OKMCU/wifi-lock/documents/密码键盘+磁力锁硬件BOM.xlsx

Sheet: Mechanical
编号 | 名称 | 型号 | 用量 | 单位 | 单价 | 最小订单量 | 最小订单价格 | 运费 | 淘宝链接 | 备注
1 | 安防门禁密码锁塑胶外壳 | FSDF-6-127 | 1 | 套 | 12 | 1 | 12 | 8 | https://item.taobao.com/item.htm?id=23332572481 | 问店家是否有机械图尺寸？
2 | 280kg单门磁力锁（信号反馈+延时） | KT-L280 | 1 | 套 | 80 | 1 | 80 | 0 | https://detail.tmall.com/item.htm?id=9399868506 | 注意安装是否需要其他配件？
3 | 螺丝等 |  |  |  | 0 | 100 | 0 | 10 |  | 小钱，螺丝暂不知用哪种，未知价格

Sheet: Electronic
编号 | 名称 | 型号 | 封装 | 用量 | 单价 | 小计 | 最小订单量 | 最小订单价格 | 运费 | 淘宝链接 | 备注
1 | PCB板 | NA | NA | 1 | 15 | 15 | 10 | 150 | 0 | https://www.sz-jlc.com | 配合键盘导电橡胶要沉金工艺防触点氧化
2 | 12V 2A 电源适配器 | NA | NA | 1 | 10.5 | 10.5 | 1 | 10.5 | 8 | https://item.taobao.com/item.htm?id=524330149101 | 最好买有地线的电源
3 | MCU处理器 | M0516LDN | LQFP-48 | 1 | 6.8 | 6.8 | 5 | 34 | 6 | https://detail.tmall.com/item.htm?id=525069682374
4 | DC-DC稳压IC | TPS5430 | SOP-8 | 1 | 3.6 | 3.6 | 5 | 18 | 3 | https://item.taobao.com/item.htm?id=547035722114
5 | 30V 5.8A N-Channel MOSFET, MAX VGS = 1.45V | AO3400 | SOT-23 | 1 | 0.24 | 0.24 | 5 | 1.2 | 3 | https://item.taobao.com/item.htm?id=580014680257
6 | Buzzers Transducer, Externally Driven Magnetic 1.5V 10mA 2.048kHz 82dB @ 1.5V, 10cm Through Hole PC Pins | AT-1220-TT-R | 1201 | 1 | 0.36 | 0.36 | 5 | 1.8 | 3 | https://item.taobao.com/item.htm?id=556001425832
7 | CAP0603 | 100nF | 0603 | 6 | 0.1 | 0.6 | 100 | 10 | 3 | NA
8 | CAP0603 | 100pF | 0603 | 1 | 0.1 | 0.1 | 100 | 10 | 3 | NA
9 | CAP0603 | 10uF | 0603 | 6 | 0.1 | 0.6 | 100 | 10 | 3 | NA
10 | 220μF 16V Aluminum Electrolytic Capacitors Radial, Can - SMD 160 mohm @ 100kHz 2000 Hrs @ 105°C | 220uF | SMD-EC-F6.3 | 1 | 0.13 | 0.13 | 50 | 6.5 | 3 | https://item.taobao.com/item.htm?id=550716514634
11 | ESP-12S Wi-Fi Module | ESP-12S | ESP-12S | 1 | 11.3 | 11.3 | 1 | 11.3 | 6 | https://item.taobao.com/item.htm?id=542762874623
12 | Header, 2-Pin, Dual row | Header 2*5 | 2.54mm Pitch | 1 | 0.2 | 0.2 | 10 | 2 | 3 | NA
13 | Typical INFRARED GaAs LED | LED | 0603 | 1 | 0.1 | 0.1 | 100 | 10 | 3 | NA
14 | Red & Blue | LED | DLED2.00x1.25mm | 1 | 0.1 | 0.1 | 100 | 10 | 3 | NA
15 | High Voltage Transistor, PNP Silicon, 3-Pin SOT-23, Pb-Free, Tape and Reel | MMBT5401LT1G | SOT-23 | 2 | 0.12 | 0.24 | 10 | 1.2 | 3 | https://item.taobao.com/item.htm?id=586188477523
16 | 0603 Resistor, 1/16W, 5% | 0R | 0603 | 1 | 0.01 | 0.01 | 100 | 1 | 0
17 | 0603 Resistor, 1/16W, 5% | 100R | 0603 | 3 | 0.01 | 0.03 | 100 | 1 | 0
18 | 0603 Resistor, 1/16W, 5% | 10k | 0603 | 4 | 0.01 | 0.04 | 100 | 1 | 0
19 | 0603 Resistor, 1/16W, 5% | 33k | 0603 | 2 | 0.01 | 0.02 | 100 | 1 | 0
20 | 0603 Resistor, 1/16W, 5% | 4.7k | 0603 | 4 | 0.01 | 0.04 | 100 | 1 | 0
21 | 0603 Resistor, 1/16W, 5% | 51R | 0603 | 1 | 0.01 | 0.01 | 100 | 1 | 0
