OKMCU/wifi-lock/documents/BOM.xls

Comment | Description | Designator | Footprint | LibRef | Quantity
AMS1117 | 三端线性稳压 | U1 | SOT-223 | AMS1117 | 1
AO3400 | 30V 5.8A N-Channel MOSFET, MAX VGS = 1.45V | Q2 | SOT95P230X110-3N | AO3400 | 1
AT-1220-TT-R | Buzzers Transducer, Externally Driven Magnetic 1.5V 10mA 2.048kHz 82dB @ 1.5V, 10cm Through Hole PC Pins | U3 | Transducer_12mm(D)x8.5mm(H)_6.5mm(P) | AT-1220-TT-R | 1
100nF | CAP0603 | C2, C4, C5, C6, C9, C11 | 0603 | CAP0603 | 6
100pF | CAP0603 | C14 | 0603 | CAP0603 | 1
10uF | CAP0603 | C1, C3, C8, C10, C12, C13 | 0603 | CAP0603 | 6
SS32 | SS32 | D2 | DO-214AC | Diode | 1
220uF | 220μF 16V Aluminum Electrolytic Capacitors Radial, Can - SMD 160 mohm @ 100kHz 2000 Hrs @ 105°C | C7 | SMD-EC-F6.3 | EEE-FPC221XAP | 1
ESP07S | ESP-07S Wi-Fi Module | M1 | ESP-07S Module | ESP-07S Module | 1
Header 2*5 | Header, 2-Pin, Dual row | P1 | HDR2X5T0.1 | Header 2*5 | 1
LED | Typical INFRARED GaAs LED | D3 | 0603 | LED | 1
LED | Red & Blue | D4 | DLED2.00x1.25mm | LED-RB | 1
M0516LDN | ARM Cortex -M0 32-bit Microcontroller | U2 | LQFP-48 | M0516LDN | 1
MMBT5401LT1G | High Voltage Transistor, PNP Silicon, 3-Pin SOT-23, Pb-Free, Tape and Reel | Q1, Q3 | ONSC-SOT-23-3-318-08_V | MMBT5401LT1G | 2
0R |  | R10 | 0603 | RES | 1
100R |  | R11, R12, R13 | 0603 | RES | 3
10k |  | R1, R2, R4, R6 | 0603 | RES | 4
33k |  | R8, R9 | 0603 | RES | 2
4.7k |  | R3, R5, R7, R15 | 0603 | RES | 4
51R |  | R14 | 0603 | RES | 1
KEY0 | Top push Switch | S0 | SW6.00x3.00mm | SW-TACT | 1
Terminal Screw 4-PIN PCB RA | Terminal Screw 4-PIN, Thru Hole, PCB Right Angle | J1, J2 | TERMSCREW4-B11.5X8.5X7.8mm/T5.0X7.5mm/RA | Terminal Screw 4-PIN PCB RA | 2
