OKMCU/wifi-lock/documents/CMD.xls

ID | Server |  | Client | Remarks
1 | @heart | <-----> | @heart | Heart Beat Packet. 1. Client will send "@heart" every 30 seconds to keep the connection alive. 2. Once received "@heart" from client, the server should echo "@heart" to client. 3. If the client does not receive "@heart" in 60 seconds, it will sending request to server to close the websocket connection.
2 | UUID? | <-----> | UUID:XX-XX-XX-XX-XX-XX-XX-XX-XX-XX-XX-XX-XX-XX-XX-XX | Universal Unique ID. 1. Every client has its own UUID. 2. Server can distinguish client by using UUID and mapping it to corresponding location or ShareOffice ID.
3 | VERIFY!{VCODE} e.g. VERIFY!AA-BB-AA-BB-AA-BB-AA-BB-AA-BB-AA-BB-AA-BB-AA-BB | <-----> | VERIFY:{ANSWER} e.g. VERIFY:CC-DD-CC-DD-CC-CC-DD-CC-DD-CC-CC-DD-CC-DD-CC-DD | Client verification. 1. Since the UUID can be sniffed by a hacker. There is a risk that the hacker can connect to server and report the same UUID in order to pose as a client. Thus, it's necessary for the server to verify the client. Steps are as below. Step 1. Server sends a verification code(VCODE) to client. VCODE should be always different. Recommanded to use VCODE = MD5(ServerTime). Step 2. Once the client receives the VCODE, it will calculate the ANSWER and reply to the server. ANSWER = MD5(VCODE+VID) ---- "+" means "VCODE.toBytes[i] + VID.toBytes[i]", where i=0~46. VCODE = MD5(ServerTime )---- Verification Code = MD5 of Server Time. VID = MD5(DEVID) ---- Verification ID = MD5 of the Device ID. Step 3. Once the server receives the answer from the client, it should check the answer is correct or not. If not correct, or the server does not receives the reply in a limited time, the server should close the connection and block the IP address for a while, such as 60sec. 2. If the server sends an illegal VCODE, e.g, "01-02-03-04", "01-02-03-04-05-06-07-08-09-10-11-12-13-14-15" "01-02-03-04-05-06-07-08-09-10-11-12-13-14-15-16-17" "01-02-03-04-05-06-07-08-09-10-11-12-13-14-15-16-1G" "01-02-03-04-05-06-07-08-09-10-11-12-13-14-15-16--17" "01-02-03-04-05-06-07-08-09-10-11-12-13-14-15-1617" then, the client will reply "VERIFY:00-00-00-00-00-00-00-00-00-00-00-00-00-00-00-00". 3. At debug stage, server can any string starting with "VERIFY!", such as "VERIFY!TEST", which is an illeg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
4 | STATE? | <-----> | STATE:OPENED STATE:CLOSED | Check the door status. 1. Reply "STATE:OPENED" if door is opened. 2. Reply "STATE:CLOSED" if door is closed.
5 | OPEN! | <-----> | OPEN:OK | Request to open the lock. 1. Client will always reply "OK" when receives the request. 2. Client will open the lock. Notice that "Lock Open" does not means "Door Open". 3. Thers's a hard time limitation of 5 seconds for "OPEN!" command. That means if server sends "OPEN!" twice or more times within 5 seconds, only the first "OPEN!" takes effect. This limitation is designed for avoiding hardware damage.
6 | PAIRING! | <-----> | PAIRING:OK | Request to set the device to Wi-Fi pairing mode (Pair to a new router). Client will always reply "OK" when receives the request.
7 | DEVID? | <-----> | DEVID:XXXXXXXX-XXXXXXXX-XXXXXXXX-XXXXXXXX-XXXXXXXX | Device ID. Device ID contains of 5 32-bit values which are 1*CompanyID, 1*ProductID, 3*ChipID. 1. Different MCU has different Chip ID. 2. DEVID will be used for building the ANSWER in verification stage.
8 | WSUPDATE!ws://YourHost.YourDomainName.com:PORT/PATH e.g. WSUPDATE!ws://www.fatdragonhk.com:8080/myHandler | <-----> | WSUPDATE:OK | Websocket Update. The websocket connection info will be saved to FLASH. 1. Server should take special care of the websocket connection info is correct. Otherwise, the client will offline forever after updating.
