OKMCU/wifi-lock/sch_pcb/WiFi_Lock_sch.pdf

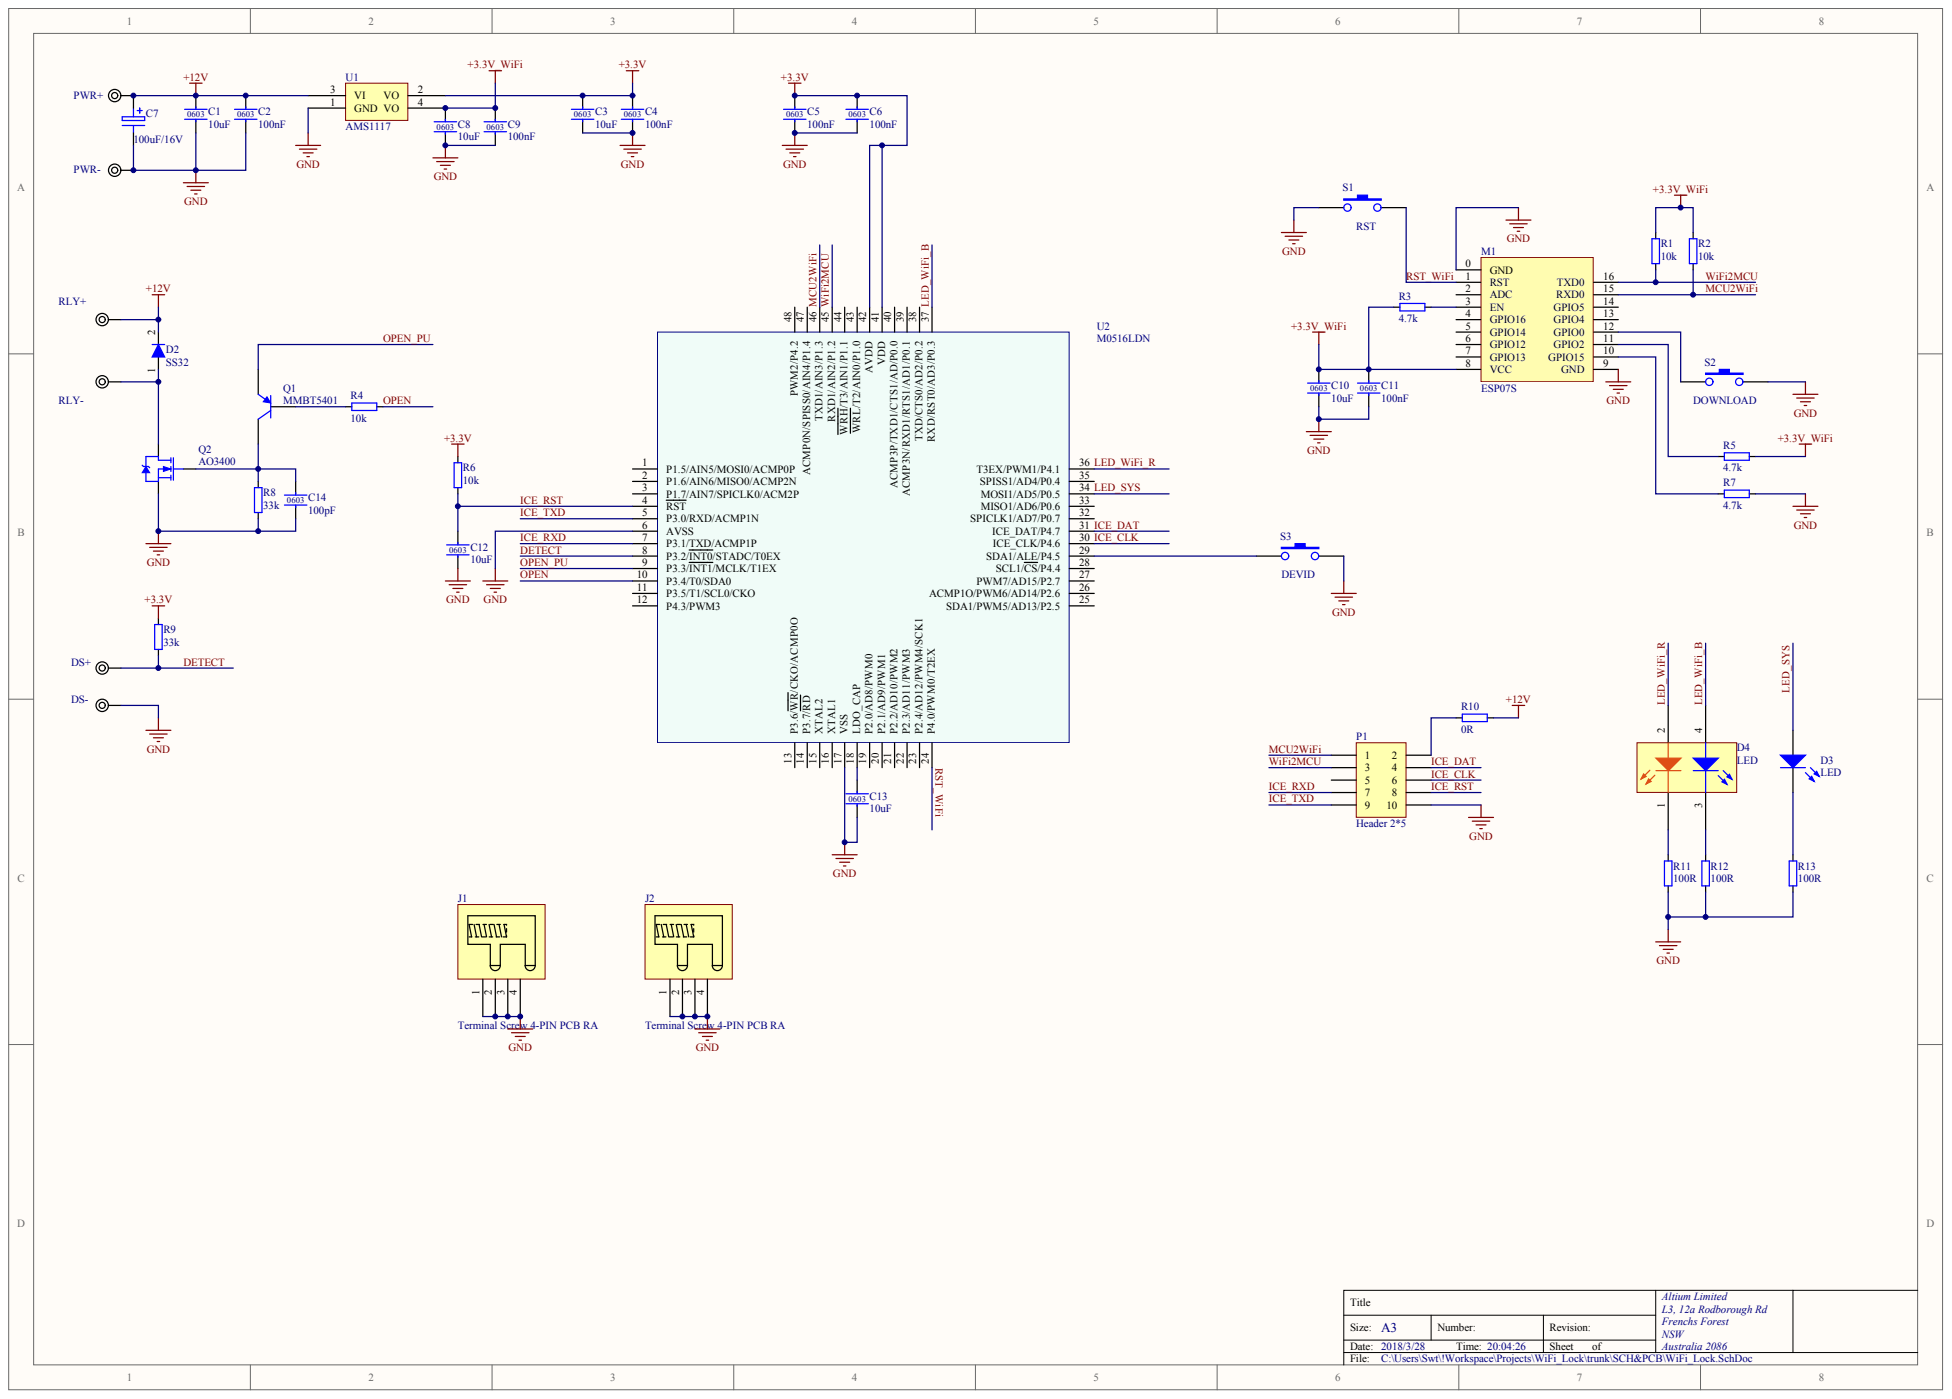
[picture p26: page 1]

Terminal Screw 4-PIN PCB RA

Altium Limited L3, 12a Rodborough Rd Frenchs Forest NSW Australia 2086

A 3 | er: | Re visio n :

Date : 2018/3/28 Tim e : 20:04:26 | | She e t o f

ck\trunk\SCH&PCB\
