OKMCU/wifi-lock/documents/7774.PDF

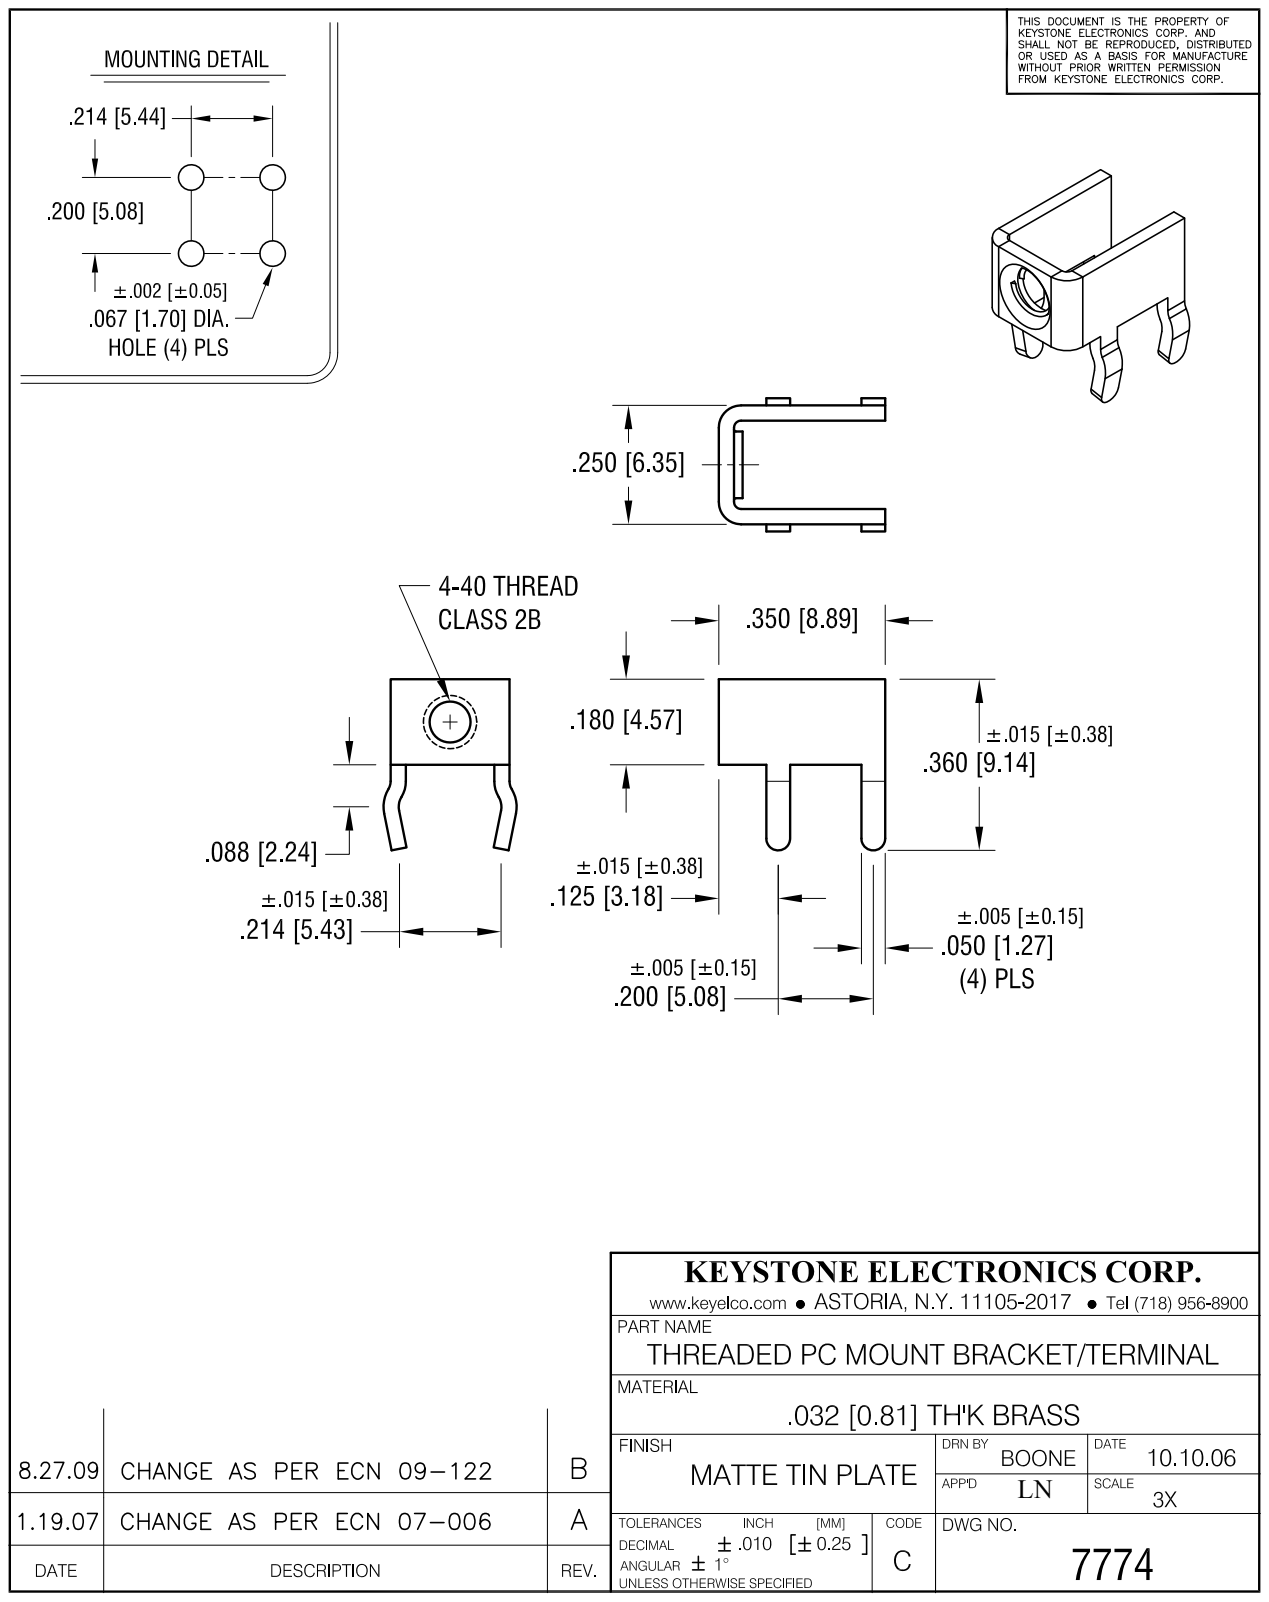
[picture p27: page 1]
