OKMCU/wifi-lock/sch_pcb/WiFi_Lock_PCB_TOP.pdf

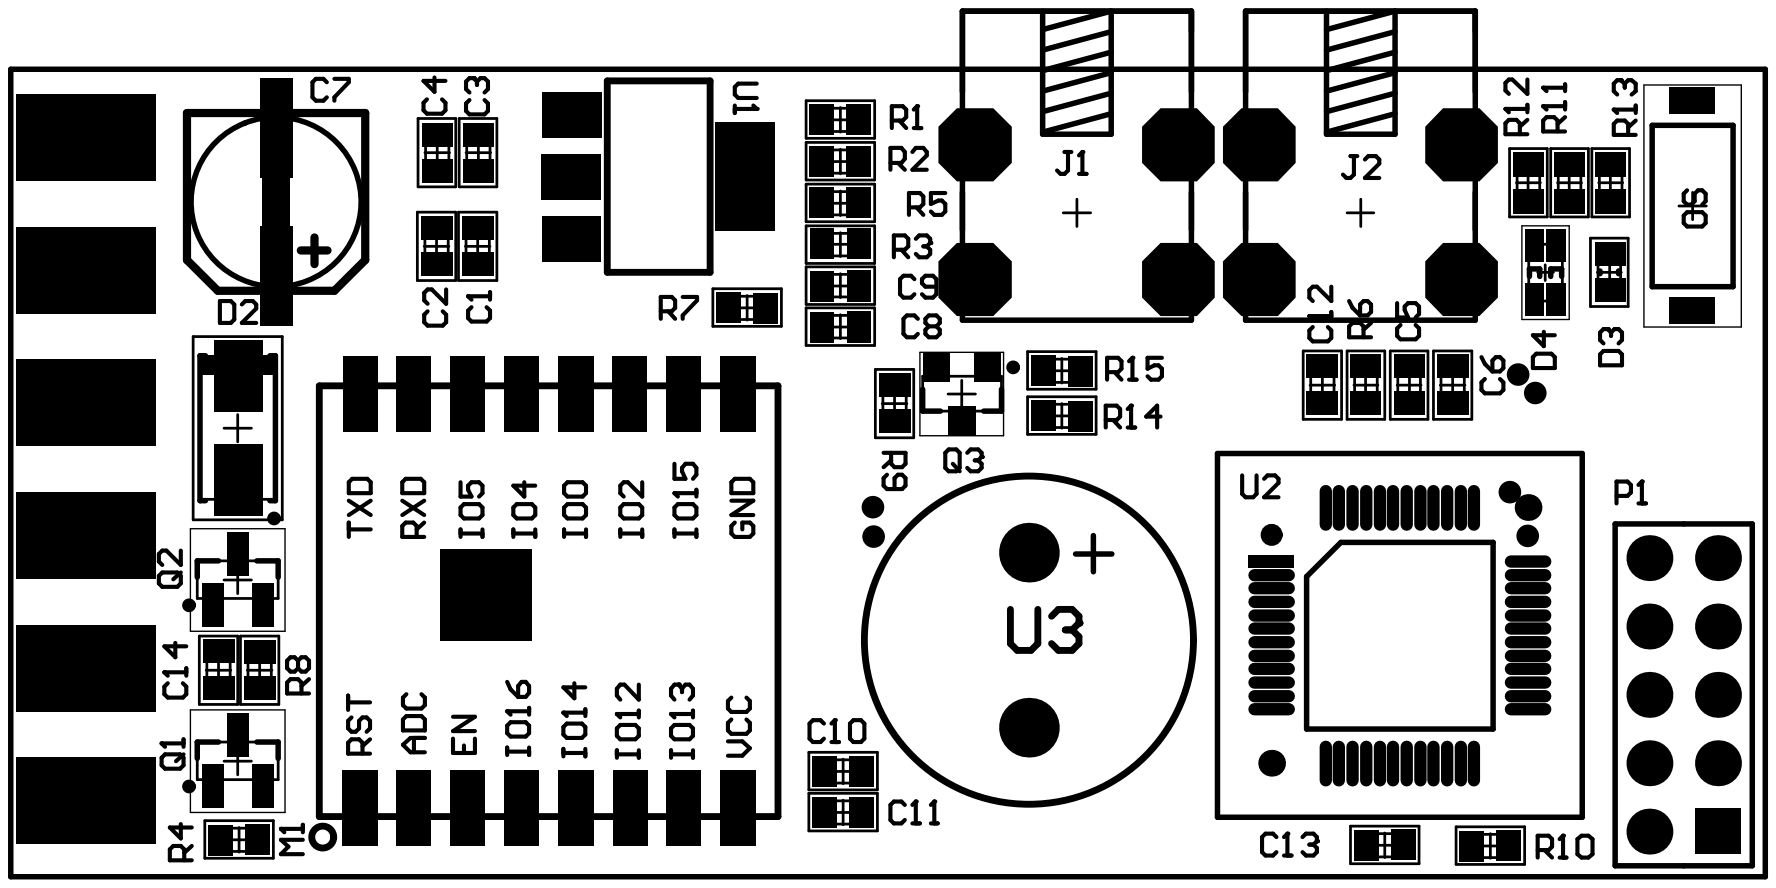
[picture p28: page 1]
