OKMCU/wifi-lock/(list of files, drawings)

Other design files:
sch_pcb/WiFi_Lock.PcbDoc
sch_pcb/WiFi_Lock.PrjPCB
sch_pcb/WiFi_Lock.SchDoc
