OKMCU/wifi-lock/firmware/osal/osal.c

/******************************************************************************

 @file  OSAL.c

 @brief This API allows the software components in the Z-stack to be written
        independently of the specifics of the operating system, kernel or
        tasking environment (including control loops or connect-to-interrupt
        systems).

 Group: WCS, BTS
 Target Device: CC2540, CC2541

 ******************************************************************************
 
 Copyright (c) 2004-2016, Texas Instruments Incorporated
 All rights reserved.

 IMPORTANT: Your use of this Software is limited to those specific rights
 granted under the terms of a software license agreement between the user
 who downloaded the software, his/her employer (which must be your employer)
 and Texas Instruments Incorporated (the "License"). You may not use this
 Software unless you agree to abide by the terms of the License. The License
 limits your use, and you acknowledge, that the Software may not be modified,
 copied or distributed unless embedded on a Texas Instruments microcontroller
 or used solely and exclusively in conjunction with a Texas Instruments radio
 frequency transceiver, which is integrated into your product. Other than for
 the foregoing purpose, you may not use, reproduce, copy, prepare derivative
 works of, modify, distribute, perform, display or sell this Software and/or
 its documentation for any purpose.

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
 Should you have any questions regarding your right to use this Software,
 contact Texas Instruments Incorporated at www.TI.com.

 ******************************************************************************
 Release Name: ble_sdk_1.4.2.2
 Release Date: 2016-06-09 06:57:09
 *****************************************************************************/

/*********************************************************************
 * INCLUDES
 */

#include <string.h>

#include "comdef.h"
//#include "hal_board.h"
#include "osal.h"
#include "osal_tasks.h"
#include "osal_memory.h"
//#include "OSAL_PwrMgr.h"
#include "osal_clock.h"

//#include "OnBoard.h"

/* HAL */
#include "hal_mcu.h"
#include "hal_drivers.h"

/*********************************************************************
 * MACROS
 */

/*********************************************************************
 * CONSTANTS
 */

/*********************************************************************
 * TYPEDEFS
 */

/*********************************************************************
 * GLOBAL VARIABLES
 */

// Message Pool Definitions
osal_msg_q_t osal_qHead;

/*********************************************************************
 * EXTERNAL VARIABLES
 */

/*********************************************************************
 * EXTERNAL FUNCTIONS
 */

/*********************************************************************
 * LOCAL VARIABLES
 */

// Index of active task
static uint8_t activeTaskID = TASK_NO_TASK;

/*********************************************************************
 * LOCAL FUNCTION PROTOTYPES
 */

static uint8_t osal_msg_enqueue_push( uint8_t destination_task, uint8_t *msg_ptr, uint8_t urgent );

/*********************************************************************
 * HELPER FUNCTIONS
 */
/* very ugly stub so Keil can compile */
#ifdef __KEIL__
char *  itoa ( int value, char * buffer, int radix )
{
  return(buffer);
}
#endif

/*********************************************************************
 * @fn      osal_strlen
 *
 * @brief
 *
 *   Calculates the length of a string.  The string must be null
 *   terminated.
 *
 * @param   char *pString - pointer to text string
 *
 * @return  int - number of characters
 */
int osal_strlen( char *pString )
{
  return (int)( strlen( pString ) );
}

/*********************************************************************
 * @fn      osal_memcpy
 *
 * @brief
 *
 *   Generic memory copy.
 *
 *   Note: This function differs from the standard memcpy(), since
 *         it returns the pointer to the next destination uint8_t. The
 *         standard memcpy() returns the original destination address.
 *
 * @param   dst - destination address
 * @param   src - source address
 * @param   len - number of bytes to copy
 *
 * @return  pointer to end of destination buffer
 */
void *osal_memcpy( void *dst, const void GENERIC *src, unsigned int len )
{
  uint8_t *pDst;
  const uint8_t GENERIC *pSrc;

  pSrc = src;
  pDst = dst;

  while ( len-- )
    *pDst++ = *pSrc++;

  return ( pDst );
}

/*********************************************************************
 * @fn      osal_revmemcpy
 *
 * @brief   Generic reverse memory copy.  Starts at the end of the
 *   source buffer, by taking the source address pointer and moving
 *   pointer ahead "len" bytes, then decrementing the pointer.
 *
 *   Note: This function differs from the standard memcpy(), since
 *         it returns the pointer to the next destination uint8_t. The
 *         standard memcpy() returns the original destination address.
 *
 * @param   dst - destination address
 * @param   src - source address
 * @param   len - number of bytes to copy
 *
 * @return  pointer to end of destination buffer
 */
void *osal_revmemcpy( void *dst, const void GENERIC *src, unsigned int len )
{
  uint8_t *pDst;
  const uint8_t GENERIC *pSrc;

  pSrc = src;
  pSrc += (len-1);
  pDst = dst;

  while ( len-- )
    *pDst++ = *pSrc--;

  return ( pDst );
}

/*********************************************************************
 * @fn      osal_memdup
 *
 * @brief   Allocates a buffer [with osal_mem_alloc()] and copies
 *          the src buffer into the newly allocated space.
 *
 * @param   src - source address
 * @param   len - number of bytes to copy
 *
 * @return  pointer to the new allocated buffer, or NULL if
 *          allocation problem.
 */
void *osal_memdup( const void GENERIC *src, unsigned int len )
{
  uint8_t *pDst;

  pDst = osal_mem_alloc( len );
  if ( pDst )
  {
    VOID osal_memcpy( pDst, src, len );
  }

  return ( (void *)pDst );
}

/*********************************************************************
 * @fn      osal_memcmp
 *
 * @brief
 *
 *   Generic memory compare.
 *
 * @param   src1 - source 1 address
 * @param   src2 - source 2 address
 * @param   len - number of bytes to compare
 *
 * @return  TRUE - same, FALSE - different
 */
uint8_t osal_memcmp( const void GENERIC *src1, const void GENERIC *src2, unsigned int len )
{
  const uint8_t GENERIC *pSrc1;
  const uint8_t GENERIC *pSrc2;

  pSrc1 = src1;
  pSrc2 = src2;

  while ( len-- )
  {
    if( *pSrc1++ != *pSrc2++ )
      return FALSE;
  }
  return TRUE;
}


/*********************************************************************
 * @fn      osal_memset
 *
 * @brief
 *
 *   Set memory buffer to value.
 *
 * @param   dest - pointer to buffer
 * @param   value - what to set each uint8_t of the message
 * @param   size - how big
 *
 * @return  pointer to destination buffer
 */
void *osal_memset( void *dest, uint8_t value, int len )
{
  return memset( dest, value, len );
}

/*********************************************************************
 * @fn      osal_build_uint16
 *
 * @brief
 *
 *   Build a uint16_t out of 2 bytes (0 then 1).
 *
 * @param   swapped - 0 then 1
 *
 * @return  uint16_t
 */
uint16_t osal_build_uint16( uint8_t *swapped )
{
  return ( BUILD_UINT16( swapped[0], swapped[1] ) );
}

/*********************************************************************
 * @fn      osal_build_uint32
 *
 * @brief
 *
 *   Build a uint32_t out of sequential bytes.
 *
 * @param   swapped - sequential bytes
 * @param   len - number of bytes in the uint8_t array
 *
 * @return  uint32_t
 */
uint32_t osal_build_uint32( uint8_t *swapped, uint8_t len )
{
  if ( len == 2 )
    return ( BUILD_UINT32( swapped[0], swapped[1], 0L, 0L ) );
  else if ( len == 3 )
    return ( BUILD_UINT32( swapped[0], swapped[1], swapped[2], 0L ) );
  else if ( len == 4 )
    return ( BUILD_UINT32( swapped[0], swapped[1], swapped[2], swapped[3] ) );
  else
    return ( (uint32_t)swapped[0] );
}

/*********************************************************************
 * @fn      _itoa
 *
 * @brief   convert a 16bit number to ASCII
 *
 * @param   num -
 *          buf -
 *          radix -
 *
 * @return  void
 *
 *********************************************************************/
void _itoa(uint16_t num, uint8_t *buf, uint8_t radix)
{
  char c,i;
  uint8_t *p, rst[5];

  p = rst;
  for ( i=0; i<5; i++,p++ )
  {
    c = num % radix;  // Isolate a digit
    *p = c + (( c < 10 ) ? '0' : '7');  // Convert to Ascii
    num /= radix;
    if ( !num )
      break;
  }

  for ( c=0 ; c<=i; c++ )
    *buf++ = *p--;  // Reverse character order

  *buf = '\0';
}

/*********************************************************************
 * @fn      _ltoa
 *
 * @brief
 *
 *   convert a long unsigned int to a string.
 *
 * @param  l - long to convert
 * @param  buf - buffer to convert to
 * @param  radix - 10 dec, 16 hex
 *
 * @return  pointer to buffer
 */
uint8_t *_ltoa( uint32_t l, uint8_t * buf, uint8_t radix )
{
  unsigned char tmp1[10] = "", tmp2[10] = "", tmp3[10] = "";
  unsigned short num1, num2, num3;
  unsigned char i;

  buf[0] = '\0';

  if ( radix == 10 )
  {
    num1 = l % 10000;
    num2 = (l / 10000) % 10000;
    num3 = (unsigned short)(l / 100000000);

    if (num3) _itoa(num3, tmp3, 10);
    if (num2) _itoa(num2, tmp2, 10);
    if (num1) _itoa(num1, tmp1, 10);

    if (num3)
    {
      strcpy((char*)buf, (char const*)tmp3);
      for (i = 0; i < 4 - strlen((char const*)tmp2); i++)
        strcat((char*)buf, "0");
    }
    strcat((char*)buf, (char const*)tmp2);
    if (num3 || num2)
    {
      for (i = 0; i < 4 - strlen((char const*)tmp1); i++)
        strcat((char*)buf, "0");
    }
    strcat((char*)buf, (char const*)tmp1);
    if (!num3 && !num2 && !num1)
      strcpy((char*)buf, "0");
  }
  else if ( radix == 16 )
  {
    num1 = l & 0x0000FFFF;
    num2 = l >> 16;

    if (num2) _itoa(num2, tmp2, 16);
    if (num1) _itoa(num1, tmp1, 16);

    if (num2)
    {
      strcpy((char*)buf,(char const*)tmp2);
      for (i = 0; i < 4 - strlen((char const*)tmp1); i++)
        strcat((char*)buf, "0");
    }
    strcat((char*)buf, (char const*)tmp1);
    if (!num2 && !num1)
      strcpy((char*)buf, "0");
  }
  else
    return NULL;

  return buf;
}

/*********************************************************************
 * @fn        osal_rand
 *
 * @brief    Random number generator
 *
 * @param   none
 *
 * @return  uint16_t - new random number
 */
uint16_t osal_rand( void )
{
  //return ( Onboard_rand() );
  return 0;
}

/*********************************************************************
 * API FUNCTIONS
 *********************************************************************/

/*********************************************************************
 * @fn      osal_msg_allocate
 *
 * @brief
 *
 *    This function is called by a task to allocate a message buffer
 *    into which the task will encode the particular message it wishes
 *    to send.  This common buffer scheme is used to strictly limit the
 *    creation of message buffers within the system due to RAM size
 *    limitations on the microprocessor.   Note that all message buffers
 *    are a fixed size (at least initially).  The parameter len is kept
 *    in case a message pool with varying fixed message sizes is later
 *    created (for example, a pool of message buffers of size LARGE,
 *    MEDIUM and SMALL could be maintained and allocated based on request
 *    from the tasks).
 *
 *
 * @param   uint8_t len  - wanted buffer length
 *
 *
 * @return  pointer to allocated buffer or NULL if allocation failed.
 */
uint8_t * osal_msg_allocate( uint16_t len )
{
  osal_msg_hdr_t *hdr;

  if ( len == 0 )
    return ( NULL );

  hdr = (osal_msg_hdr_t *) osal_mem_alloc( (short)(len + sizeof( osal_msg_hdr_t )) );
  if ( hdr )
  {
    hdr->next = NULL;
    hdr->len = len;
    hdr->dest_id = TASK_NO_TASK;
    return ( (uint8_t *) (hdr + 1) );
  }
  else
    return ( NULL );
}

/*********************************************************************
 * @fn      osal_msg_deallocate
 *
 * @brief
 *
 *    This function is used to deallocate a message buffer. This function
 *    is called by a task (or processing element) after it has finished
 *    processing a received message.
 *
 *
 * @param   uint8_t *msg_ptr - pointer to new message buffer
 *
 * @return  SUCCESS, INVALID_MSG_POINTER
 */
uint8_t osal_msg_deallocate( uint8_t *msg_ptr )
{
  uint8_t *x;

  if ( msg_ptr == NULL )
    return ( INVALID_MSG_POINTER );

  // don't deallocate queued buffer
  if ( OSAL_MSG_ID( msg_ptr ) != TASK_NO_TASK )
    return ( MSG_BUFFER_NOT_AVAIL );

  x = (uint8_t *)((uint8_t *)msg_ptr - sizeof( osal_msg_hdr_t ));

  osal_mem_free( (void *)x );

  return ( SUCCESS );
}

/*********************************************************************
 * @fn      osal_msg_send
 *
 * @brief
 *
 *    This function is called by a task to send a command message to
 *    another task or processing element.  The sending_task field must
 *    refer to a valid task, since the task ID will be used
 *    for the response message.  This function will also set a message
 *    ready event in the destination tasks event list.
 *
 *
 * @param   uint8_t destination_task - Send msg to Task ID
 * @param   uint8_t *msg_ptr - pointer to new message buffer
 *
 * @return  SUCCESS, INVALID_TASK, INVALID_MSG_POINTER
 */
uint8_t osal_msg_send( uint8_t destination_task, uint8_t *msg_ptr )
{
  return ( osal_msg_enqueue_push( destination_task, msg_ptr, FALSE ) );
}

/*********************************************************************
 * @fn      osal_msg_push_front
 *
 * @brief
 *
 *    This function is called by a task to push a command message
 *    to the head of the OSAL queue. The destination_task field
 *    must refer to a valid task, since the task ID will be used to
 *    send the message to. This function will also set a message
 *    ready event in the destination task's event list.
 *
 * @param   uint8_t destination_task - Send msg to Task ID
 * @param   uint8_t *msg_ptr - pointer to message buffer
 *
 * @return  SUCCESS, INVALID_TASK, INVALID_MSG_POINTER
 */
uint8_t osal_msg_push_front( uint8_t destination_task, uint8_t *msg_ptr )
{
  return ( osal_msg_enqueue_push( destination_task, msg_ptr, TRUE ) );
}

/*********************************************************************
 * @fn      osal_msg_enqueue_push
 *
 * @brief
 *
 *    This function is called by a task to either enqueue (append to
 *    queue) or push (prepend to queue) a command message to the OSAL
 *    queue. The destination_task field must refer to a valid task,
 *    since the task ID will be used to send the message to. This 
 *    function will also set a message ready event in the destination
 *    task's event list.
 *
 * @param   uint8_t destination_task - Send msg to Task ID
 * @param   uint8_t *msg_ptr - pointer to message buffer
 * @param   uint8_t push - TRUE to push, otherwise enqueue
 *
 * @return  SUCCESS, INVALID_TASK, INVALID_MSG_POINTER
 */
static uint8_t osal_msg_enqueue_push( uint8_t destination_task, uint8_t *msg_ptr, uint8_t push )
{
  if ( msg_ptr == NULL )
  {
    return ( INVALID_MSG_POINTER );
  }


  if ( destination_task >= tasksCnt )
  {
    osal_msg_deallocate( msg_ptr );
    return ( INVALID_TASK );
  }

  // Check the message header
  if ( OSAL_MSG_NEXT( msg_ptr ) != NULL ||
       OSAL_MSG_ID( msg_ptr ) != TASK_NO_TASK )
  {
    osal_msg_deallocate( msg_ptr );
    return ( INVALID_MSG_POINTER );
  }

  OSAL_MSG_ID( msg_ptr ) = destination_task;

  if ( push == TRUE )
  {
    // prepend the message
    osal_msg_push( &osal_qHead, msg_ptr );
  }
  else
  {
    // append the message
    osal_msg_enqueue( &osal_qHead, msg_ptr );
  }

  // Signal the task that a message is waiting
  osal_set_event( destination_task, SYS_EVENT_MSG );

  return ( SUCCESS );
}

/*********************************************************************
 * @fn      osal_msg_receive
 *
 * @brief
 *
 *    This function is called by a task to retrieve a received command
 *    message. The calling task must deallocate the message buffer after
 *    processing the message using the osal_msg_deallocate() call.
 *
 * @param   uint8_t task_id - receiving tasks ID
 *
 * @return  *uint8_t - message information or NULL if no message
 */
uint8_t *osal_msg_receive( uint8_t task_id )
{
  osal_msg_hdr_t *listHdr;
  osal_msg_hdr_t *prevHdr = NULL;
  osal_msg_hdr_t *foundHdr = NULL;
  //halIntState_t   intState;

  // Hold off interrupts
  HAL_ENTER_CRITICAL_SECTION();

  // Point to the top of the queue
  listHdr = osal_qHead;

  // Look through the queue for a message that belongs to the asking task
  while ( listHdr != NULL )
  {
    if ( (listHdr - 1)->dest_id == task_id )
    {
      if ( foundHdr == NULL )
      {
        // Save the first one
        foundHdr = listHdr;
      }
      else
      {
        // Second msg found, stop looking
        break;
      }
    }
    if ( foundHdr == NULL )
    {
      prevHdr = listHdr;
    }
    listHdr = OSAL_MSG_NEXT( listHdr );
  }

  // Is there more than one?
  if ( listHdr != NULL )
  {
    // Yes, Signal the task that a message is waiting
    osal_set_event( task_id, SYS_EVENT_MSG );
  }
  else
  {
    // No more
    osal_clear_event( task_id, SYS_EVENT_MSG );
  }

  // Did we find a message?
  if ( foundHdr != NULL )
  {
    // Take out of the link list
    osal_msg_extract( &osal_qHead, foundHdr, prevHdr );
  }

  // Release interrupts
  HAL_EXIT_CRITICAL_SECTION();

  return ( (uint8_t*) foundHdr );
}

/**************************************************************************************************
 * @fn          osal_msg_find
 *
 * @brief       This function finds in place an OSAL message matching the task_id and event
 *              parameters.
 *
 * input parameters
 *
 * @param       task_id - The OSAL task id that the enqueued OSAL message must match.
 * @param       event - The OSAL event id that the enqueued OSAL message must match.
 *
 * output parameters
 *
 * None.
 *
 * @return      NULL if no match, otherwise an in place pointer to the matching OSAL message.
 **************************************************************************************************
 */
osal_event_hdr_t *osal_msg_find(uint8_t task_id, uint8_t event)
{
  osal_msg_hdr_t *pHdr;
  //halIntState_t intState;

  HAL_ENTER_CRITICAL_SECTION();  // Hold off interrupts.

  pHdr = osal_qHead;  // Point to the top of the queue.

  // Look through the queue for a message that matches the task_id and event parameters.
  while (pHdr != NULL)
  {
    if (((pHdr-1)->dest_id == task_id) && (((osal_event_hdr_t *)pHdr)->event == event))
    {
      break;
    }

    pHdr = OSAL_MSG_NEXT(pHdr);
  }

  HAL_EXIT_CRITICAL_SECTION();  // Release interrupts.

  return (osal_event_hdr_t *)pHdr;
}

/**************************************************************************************************
 * @fn          osal_msg_count
 *
 * @brief       This function counts the number of messages, in the OSAL message queue with a
 *              a given task ID and message event type.
 *
 * input parameters
 *
 * @param       task_id - The OSAL task id that the enqueued OSAL message must match.
 * @param       event - The OSAL event id that the enqueued OSAL message must match. 0xFF for 
 *              all events.
 *
 * output parameters
 *
 * None.
 *
 * @return      The number of OSAL messages that match the task ID and Event.
 **************************************************************************************************
 */
uint8_t osal_msg_count( uint8_t task_id, uint8_t event )
{
  uint8_t count = 0;
  osal_msg_hdr_t *pHdr;
  //halIntState_t intState;

  HAL_ENTER_CRITICAL_SECTION();  // Hold off interrupts.

  pHdr = osal_qHead;  // Point to the top of the queue.

  // Look through the queue for a message that matches the task_id and event parameters.
  while (pHdr != NULL)
  {
    if ( ((pHdr-1)->dest_id == task_id) 
        && ((event == 0xFF) || (((osal_event_hdr_t *)pHdr)->event == event)) )
    {
      count++;
    }

    pHdr = OSAL_MSG_NEXT(pHdr);
  }

  HAL_EXIT_CRITICAL_SECTION();  // Release interrupts.

  return ( count );
}

/*********************************************************************
 * @fn      osal_msg_enqueue
 *
 * @brief
 *
 *    This function enqueues an OSAL message into an OSAL queue.
 *
 * @param   osal_msg_q_t *q_ptr - OSAL queue
 * @param   void *msg_ptr  - OSAL message
 *
 * @return  none
 */
void osal_msg_enqueue( osal_msg_q_t *q_ptr, void *msg_ptr )
{
  void *list;
  //halIntState_t intState;

  // Hold off interrupts
  HAL_ENTER_CRITICAL_SECTION();

  OSAL_MSG_NEXT( msg_ptr ) = NULL;
  // If first message in queue
  if ( *q_ptr == NULL )
  {
    *q_ptr = msg_ptr;
  }
  else
  {
    // Find end of queue
    for ( list = *q_ptr; OSAL_MSG_NEXT( list ) != NULL; list = OSAL_MSG_NEXT( list ) );

    // Add message to end of queue
    OSAL_MSG_NEXT( list ) = msg_ptr;
  }

  // Re-enable interrupts
  HAL_EXIT_CRITICAL_SECTION();
}

/*********************************************************************
 * @fn      osal_msg_dequeue
 *
 * @brief
 *
 *    This function dequeues an OSAL message from an OSAL queue.
 *
 * @param   osal_msg_q_t *q_ptr - OSAL queue
 *
 * @return  void * - pointer to OSAL message or NULL of queue is empty.
 */
void *osal_msg_dequeue( osal_msg_q_t *q_ptr )
{
  void *msg_ptr = NULL;
  //halIntState_t intState;

  // Hold off interrupts
  HAL_ENTER_CRITICAL_SECTION();

  if ( *q_ptr != NULL )
  {
    // Dequeue message
    msg_ptr = *q_ptr;
    *q_ptr = OSAL_MSG_NEXT( msg_ptr );
    OSAL_MSG_NEXT( msg_ptr ) = NULL;
    OSAL_MSG_ID( msg_ptr ) = TASK_NO_TASK;
  }

  // Re-enable interrupts
  HAL_EXIT_CRITICAL_SECTION();

  return msg_ptr;
}

/*********************************************************************
 * @fn      osal_msg_push
 *
 * @brief
 *
 *    This function pushes an OSAL message to the head of an OSAL
 *    queue.
 *
 * @param   osal_msg_q_t *q_ptr - OSAL queue
 * @param   void *msg_ptr  - OSAL message
 *
 * @return  none
 */
void osal_msg_push( osal_msg_q_t *q_ptr, void *msg_ptr )
{
  //halIntState_t intState;

  // Hold off interrupts
  HAL_ENTER_CRITICAL_SECTION();

  // Push message to head of queue
  OSAL_MSG_NEXT( msg_ptr ) = *q_ptr;
  *q_ptr = msg_ptr;

  // Re-enable interrupts
  HAL_EXIT_CRITICAL_SECTION();
}

/*********************************************************************
 * @fn      osal_msg_extract
 *
 * @brief
 *
 *    This function extracts and removes an OSAL message from the
 *    middle of an OSAL queue.
 *
 * @param   osal_msg_q_t *q_ptr - OSAL queue
 * @param   void *msg_ptr  - OSAL message to be extracted
 * @param   void *prev_ptr  - OSAL message before msg_ptr in queue
 *
 * @return  none
 */
void osal_msg_extract( osal_msg_q_t *q_ptr, void *msg_ptr, void *prev_ptr )
{
  //halIntState_t intState;

  // Hold off interrupts
  HAL_ENTER_CRITICAL_SECTION();

  if ( msg_ptr == *q_ptr )
  {
    // remove from first
    *q_ptr = OSAL_MSG_NEXT( msg_ptr );
  }
  else
  {
    // remove from middle
    OSAL_MSG_NEXT( prev_ptr ) = OSAL_MSG_NEXT( msg_ptr );
  }
  OSAL_MSG_NEXT( msg_ptr ) = NULL;
  OSAL_MSG_ID( msg_ptr ) = TASK_NO_TASK;

  // Re-enable interrupts
  HAL_EXIT_CRITICAL_SECTION();
}

/*********************************************************************
 * @fn      osal_msg_enqueue_max
 *
 * @brief
 *
 *    This function enqueues an OSAL message into an OSAL queue if
 *    the length of the queue is less than max.
 *
 * @param   osal_msg_q_t *q_ptr - OSAL queue
 * @param   void *msg_ptr  - OSAL message
 * @param   uint8_t max - maximum length of queue
 *
 * @return  TRUE if message was enqueued, FALSE otherwise
 */
uint8_t osal_msg_enqueue_max( osal_msg_q_t *q_ptr, void *msg_ptr, uint8_t max )
{
  void *list;
  uint8_t ret = FALSE;
  //halIntState_t intState;

  // Hold off interrupts
  HAL_ENTER_CRITICAL_SECTION();

  // If first message in queue
  if ( *q_ptr == NULL )
  {
    *q_ptr = msg_ptr;
    ret = TRUE;
  }
  else
  {
    // Find end of queue or max
    list = *q_ptr;
    max--;
    while ( (OSAL_MSG_NEXT( list ) != NULL) && (max > 0) )
    {
      list = OSAL_MSG_NEXT( list );
      max--;
    }

    // Add message to end of queue if max not reached
    if ( max != 0 )
    {
      OSAL_MSG_NEXT( list ) = msg_ptr;
      ret = TRUE;
    }
  }

  // Re-enable interrupts
  HAL_EXIT_CRITICAL_SECTION();

  return ret;
}

/*********************************************************************
 * @fn      osal_set_event
 *
 * @brief
 *
 *    This function is called to set the event flags for a task. The
 *    event passed in is OR'd into the task's event variable.
 *
 * @param   uint8_t task_id - receiving tasks ID
 * @param   uint8_t event_flag - what event to set
 *
 * @return  SUCCESS, MSG_BUFFER_NOT_AVAIL, FAILURE, INVALID_TASK
 */
uint8_t osal_set_event( uint8_t task_id, uint16_t event_flag )
{
  if ( task_id < tasksCnt )
  {
    //halIntState_t   intState;
    HAL_ENTER_CRITICAL_SECTION();           // Hold off interrupts
    tasksEvents[task_id] |= event_flag;     // Stuff the event bit(s)
    HAL_EXIT_CRITICAL_SECTION();            // Release interrupts
    return ( SUCCESS );
  }
   else
  {
    return ( INVALID_TASK );
  }
}

/*********************************************************************
 * @fn      osal_clear_event
 *
 * @brief
 *
 *    This function is called to clear the event flags for a task. The
 *    event passed in is masked out of the task's event variable.
 *
 * @param   uint8_t task_id - receiving tasks ID
 * @param   uint8_t event_flag - what event to clear
 *
 * @return  SUCCESS, INVALID_TASK
 */
uint8_t osal_clear_event( uint8_t task_id, uint16_t event_flag )
{
  if ( task_id < tasksCnt )
  {
    //halIntState_t   intState;
    HAL_ENTER_CRITICAL_SECTION();    // Hold off interrupts
    tasksEvents[task_id] &= ~(event_flag);   // Clear the event bit(s)
    HAL_EXIT_CRITICAL_SECTION();     // Release interrupts
    return ( SUCCESS );
  }
   else
  {
    return ( INVALID_TASK );
  }
}

/*********************************************************************
 * @fn      osal_isr_register
 *
 * @brief
 *
 *   This function is called to register a service routine with an
 *   interrupt. When the interrupt occurs, this service routine is called.
 *
 * @param   uint8_t interrupt_id - Interrupt number
 * @param   void (*isr_ptr)( uint8_t* ) - function pointer to ISR
 *
 * @return  SUCCESS, INVALID_INTERRUPT_ID,
 */
uint8_t osal_isr_register( uint8_t interrupt_id, void (*isr_ptr)( uint8_t* ) )
{
  // Remove these statements when functionality is complete
  (void)interrupt_id;
  (void)isr_ptr;
  return ( SUCCESS );
}

/*********************************************************************
 * @fn      osal_int_enable
 *
 * @brief
 *
 *   This function is called to enable an interrupt. Once enabled,
 *   occurrence of the interrupt causes the service routine associated
 *   with that interrupt to be called.
 *
 *   If INTS_ALL is the interrupt_id, interrupts (in general) are enabled.
 *   If a single interrupt is passed in, then interrupts still have
 *   to be enabled with another call to INTS_ALL.
 *
 * @param   uint8_t interrupt_id - Interrupt number
 *
 * @return  SUCCESS or INVALID_INTERRUPT_ID
 */
uint8_t osal_int_enable( uint8_t interrupt_id )
{

  if ( interrupt_id == INTS_ALL )
  {
    HAL_ENABLE_INTERRUPTS();
    return ( SUCCESS );
  }
  else
  {
    return ( INVALID_INTERRUPT_ID );
  }
}

/*********************************************************************
 * @fn      osal_int_disable
 *
 * @brief
 *
 *   This function is called to disable an interrupt. When a disabled
 *   interrupt occurs, the service routine associated with that
 *   interrupt is not called.
 *
 *   If INTS_ALL is the interrupt_id, interrupts (in general) are disabled.
 *   If a single interrupt is passed in, then just that interrupt is disabled.
 *
 * @param   uint8_t interrupt_id - Interrupt number
 *
 * @return  SUCCESS or INVALID_INTERRUPT_ID
 */
uint8_t osal_int_disable( uint8_t interrupt_id )
{

  if ( interrupt_id == INTS_ALL )
  {
    HAL_DISABLE_INTERRUPTS();
    return ( SUCCESS );
  }
  else
  {
    return ( INVALID_INTERRUPT_ID );
  }
}

/*********************************************************************
 * @fn      osal_init_system
 *
 * @brief
 *
 *   This function initializes the "task" system by creating the
 *   tasks defined in the task table (OSAL_Tasks.h).
 *
 * @param   void
 *
 * @return  SUCCESS
 */
uint8_t osal_init_system( void )
{
  // Initialize the Memory Allocation System
  osal_mem_init();

  // Initialize the message queue
  osal_qHead = NULL;

  // Initialize the timers
  osalTimerInit();

  // Initialize the Power Management System
  //osal_pwrmgr_init();

  // Initialize the system tasks.
  osalInitTasks();

  // Setup efficient search for the first free block of heap.
  osal_mem_kick();

  return ( SUCCESS );
}

/*********************************************************************
 * @fn      osal_start_system
 *
 * @brief
 *
 *   This function is the main loop function of the task system (if
 *   ZBIT and UBIT are not defined). This Function doesn't return.
 *
 * @param   void
 *
 * @return  none
 */
void osal_start_system( void )
{
  for(;;)  // Forever Loop
  {
    osal_run_system();
  }
}

/*********************************************************************
 * @fn      osal_run_system
 *
 * @brief
 *
 *   This function will make one pass through the OSAL taskEvents table
 *   and call the task_event_processor() function for the first task that
 *   is found with at least one event pending. If there are no pending
 *   events (all tasks), this function puts the processor into Sleep.
 *
 * @param   void
 *
 * @return  none
 */
void osal_run_system( void )
{
  uint8_t idx = 0;
  uint16_t events;
  
  osalTimeUpdate();

  Hal_ProcessPoll();

  do {
    if (tasksEvents[idx])  // Task is highest priority that is ready.
    {
      break;
    }
  } while (++idx < tasksCnt);

  if (idx < tasksCnt)
  {
    
    //halIntState_t intState;

    HAL_ENTER_CRITICAL_SECTION();
    events = tasksEvents[idx];
    tasksEvents[idx] = 0;  // Clear the Events for this task.
    HAL_EXIT_CRITICAL_SECTION();

    activeTaskID = idx;
    events = (tasksArr[idx])( idx, events );
    activeTaskID = TASK_NO_TASK;

    HAL_ENTER_CRITICAL_SECTION();
    tasksEvents[idx] |= events;  // Add back unprocessed events to the current task.
    HAL_EXIT_CRITICAL_SECTION();
  }
#if defined( POWER_SAVING )
  else  // Complete pass through all task events with no activity?
  {
    osal_pwrmgr_powerconserve();  // Put the processor/system into sleep
  }
#endif
}

/*********************************************************************
 * @fn      osal_buffer_uint32
 *
 * @brief
 *
 *   Buffer an uint32_t value - LSB first.
 *
 * @param   buf - buffer
 * @param   val - uint32_t value
 *
 * @return  pointer to end of destination buffer
 */
uint8_t* osal_buffer_uint32( uint8_t *buf, uint32_t val )
{
  *buf++ = BREAK_UINT32( val, 0 );
  *buf++ = BREAK_UINT32( val, 1 );
  *buf++ = BREAK_UINT32( val, 2 );
  *buf++ = BREAK_UINT32( val, 3 );

  return buf;
}

/*********************************************************************
 * @fn      osal_buffer_uint24
 *
 * @brief
 *
 *   Buffer an uint24 value - LSB first. Note that type uint24 is
 *   typedef to uint32_t in comdef.h
 *
 * @param   buf - buffer
 * @param   val - uint24 value
 *
 * @return  pointer to end of destination buffer
 */
uint8_t* osal_buffer_uint24( uint8_t *buf, uint24 val )
{
  *buf++ = BREAK_UINT32( val, 0 );
  *buf++ = BREAK_UINT32( val, 1 );
  *buf++ = BREAK_UINT32( val, 2 );

  return buf;
}

/*********************************************************************
 * @fn      osal_isbufset
 *
 * @brief
 *
 *   Is all of the array elements set to a value?
 *
 * @param   buf - buffer to check
 * @param   val - value to check each array element for
 * @param   len - length to check
 *
 * @return  TRUE if all "val"
 *          FALSE otherwise
 */
uint8_t osal_isbufset( uint8_t *buf, uint8_t val, uint8_t len )
{
  uint8_t x;

  if ( buf == NULL )
  {
    return ( FALSE );
  }

  for ( x = 0; x < len; x++ )
  {
    // Check for non-initialized value
    if ( buf[x] != val )
    {
      return ( FALSE );
    }
  }
  return ( TRUE );
}

/*********************************************************************
 * @fn      osal_self
 *
 * @brief
 *
 *   This function returns the task ID of the current (active) task.
 *
 * @param   void
 *
 * @return   active task ID or TASK_NO_TASK if no task is active
 */
uint8_t osal_self( void )
{
  return ( activeTaskID );
}

/*********************************************************************
 */
