OKMCU/wifi-lock/firmware/osal/osal_clock.c

/******************************************************************************

 @file  OSAL_ClockBLE.c

 @brief OSAL Clock definition and manipulation functions for BLE projects.

 Group: WCS, BTS
 Target Device: CC2540, CC2541

 ******************************************************************************
 
 Copyright (c) 2008-2016, Texas Instruments Incorporated
 All rights reserved.

 IMPORTANT: Your use of this Software is limited to those specific rights
 granted under the terms of a software license agreement between the user
 who downloaded the software, his/her employer (which must be your employer)
 and Texas Instruments Incorporated (the "License"). You may not use this
 Software unless you agree to abide by the terms of the License. The License
 limits your use, and you acknowledge, that the Software may not be modified,
 copied or distributed unless embedded on a Texas Instruments microcontroller
 or used solely and exclusively in conjunction with a Texas Instruments radio
 frequency transceiver, which is integrated into your product. Other than for
 the foregoing purpose, you may not use, reproduce, copy, prepare derivative
 works of, modify, distribute, perform, display or sell this Software and/or
 its documentation for any purpose.

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
 Should you have any questions regarding your right to use this Software,
 contact Texas Instruments Incorporated at www.TI.com.

 ******************************************************************************
 Release Name: ble_sdk_1.4.2.2
 Release Date: 2016-06-09 06:57:09
 *****************************************************************************/

/*********************************************************************
 * INCLUDES
 */

#include <stdint.h>
#include "comdef.h"
//#include "OnBoard.h"
#include "osal.h"
#include "osal_clock.h"

/*********************************************************************
 * MACROS
 */

#define	YearLength(yr)	(IsLeapYear(yr) ? 366 : 365)

/*********************************************************************
 * CONSTANTS
 */

// (MAXCALCTICKS * 5) + (max remainder) must be <= (uint16_t max),
// so: (13105 * 5) + 7 <= 65535
//#define MAXCALCTICKS  ((uint16_t)(13105))

#define	BEGYEAR	        2000     // UTC started at 00:00:00 January 1, 2000

#define	DAY             86400UL  // 24 hours * 60 minutes * 60 seconds

/*********************************************************************
 * TYPEDEFS
 */

/*********************************************************************
 * GLOBAL VARIABLES
 */

/*********************************************************************
 * EXTERNAL VARIABLES
 */

/*********************************************************************
 * EXTERNAL FUNCTIONS
 */
//extern uint16_t ll_McuPrecisionCount(void);

/*********************************************************************
 * LOCAL VARIABLES
 */
//static uint16_t previousLLTimerTick = 0;
//static uint16_t remUsTicks = 0;
static uint16_t systick = 0;
static uint16_t preSystick = 0;
static uint16_t timeMSec = 0;

// number of seconds since 0 hrs, 0 minutes, 0 seconds, on the
// 1st of January 2000 UTC
UTCTime OSAL_timeSeconds = 0;

/*********************************************************************
 * LOCAL FUNCTION PROTOTYPES
 */
static uint8_t monthLength( uint8_t lpyr, uint8_t mon );

static void osalClockUpdate( uint16_t elapsedMSec );

/*********************************************************************
 * FUNCTIONS
 *********************************************************************/

void osalSystickUpdate( void )
{
    systick++;
}

/*********************************************************************
 * @fn      osalTimeUpdate
 *
 * @brief   Uses the free running rollover count of the MAC backoff timer;
 *          this timer runs freely with a constant 320 usec interval.  The
 *          count of 320-usec ticks is converted to msecs and used to update
 *          the OSAL clock and Timers by invoking osalClockUpdate() and
 *          osalTimerUpdate().  This function is intended to be invoked
 *          from the background, not interrupt level.
 *
 * @param   None.
 *
 * @return  None.
 */
void osalTimeUpdate( void )
{
    uint16_t curSystick;
    uint16_t elapsedMSec = 0;

    curSystick = systick;
    
    if ( curSystick != preSystick )
    {
        // Update OSAL Clock and Timers

        if(curSystick > preSystick)
        {
            elapsedMSec = curSystick - preSystick;
        }
        else
        {
            elapsedMSec = UINT16_MAX - preSystick + curSystick;
        }

        preSystick = curSystick;
        
        if ( elapsedMSec )
        {
          osalClockUpdate( elapsedMSec );
          osalTimerUpdate( elapsedMSec );
        }
    }
}

/*********************************************************************
 * @fn      osalClockUpdate
 *
 * @brief   Updates the OSAL Clock time with elapsed milliseconds.
 *
 * @param   elapsedMSec - elapsed milliseconds
 *
 * @return  none
 */
static void osalClockUpdate( uint16_t elapsedMSec )
{
  // Add elapsed milliseconds to the saved millisecond portion of time
  timeMSec += elapsedMSec;

  // Roll up milliseconds to the number of seconds
  if ( timeMSec >= 1000 )
  {
    OSAL_timeSeconds += timeMSec / 1000;
    timeMSec = timeMSec % 1000;
  }
}

/*********************************************************************
 * @fn      osal_setClock
 *
 * @brief   Set the new time.  This will only set the seconds portion
 *          of time and doesn't change the factional second counter.
 *
 * @param   newTime - number of seconds since 0 hrs, 0 minutes,
 *                    0 seconds, on the 1st of January 2000 UTC
 *
 * @return  none
 */
void osal_setClock( UTCTime newTime )
{
  OSAL_timeSeconds = newTime;
}

/*********************************************************************
 * @fn      osal_getClock
 *
 * @brief   Gets the current time.  This will only return the seconds
 *          portion of time and doesn't include the factional second
 *          counter.
 *
 * @param   none
 *
 * @return  number of seconds since 0 hrs, 0 minutes, 0 seconds,
 *          on the 1st of January 2000 UTC
 */
UTCTime osal_getClock( void )
{
  return ( OSAL_timeSeconds );
}

uint16_t osal_getClockMSec( void )
{
    return timeMSec;
}
/*********************************************************************
 * @fn      osal_ConvertUTCTime
 *
 * @brief   Converts UTCTime to UTCTimeStruct
 *
 * @param   tm - pointer to breakdown struct
 *
 * @param   secTime - number of seconds since 0 hrs, 0 minutes,
 *          0 seconds, on the 1st of January 2000 UTC
 *
 * @return  none
 */
void osal_ConvertUTCTime( UTCTimeStruct *tm, UTCTime secTime )
{
  uint32_t day;
  uint16_t numDays;
  // calculate the time less than a day - hours, minutes, seconds
  {
    day = secTime % DAY;
    tm->seconds = day % 60UL;
    tm->minutes = (day % 3600UL) / 60UL;
    tm->hour = day / 3600UL;
  }

  // Fill in the calendar - day, month, year
  {
    numDays = secTime / DAY;
    tm->year = BEGYEAR;
    while ( numDays >= YearLength( tm->year ) )
    {
      numDays -= YearLength( tm->year );
      tm->year++;
    }

    tm->month = 0;
    while ( numDays >= monthLength( IsLeapYear( tm->year ), tm->month ) )
    {
      numDays -= monthLength( IsLeapYear( tm->year ), tm->month );
      tm->month++;
    }

    tm->day = numDays;
  }
}

/*********************************************************************
 * @fn      monthLength
 *
 * @param   lpyr - 1 for leap year, 0 if not
 *
 * @param   mon - 0 - 11 (jan - dec)
 *
 * @return  number of days in specified month
 */
static uint8_t monthLength( uint8_t lpyr, uint8_t mon )
{
  uint8_t days = 31;

  if ( mon == 1 ) // feb
  {
    days = ( 28 + lpyr );
  }
  else
  {
    if ( mon > 6 ) // aug-dec
    {
      mon--;
    }

    if ( mon & 1 )
    {
      days = 30;
    }
  }

  return ( days );
}

/*********************************************************************
 * @fn      osal_ConvertUTCSecs
 *
 * @brief   Converts a UTCTimeStruct to UTCTime
 *
 * @param   tm - pointer to provided struct
 *
 * @return  number of seconds since 00:00:00 on 01/01/2000 (UTC)
 */
UTCTime osal_ConvertUTCSecs( UTCTimeStruct *tm )
{
  uint32_t seconds;
  uint16_t days;
  uint16_t year;
  int8_t month;
  
  /* Seconds for the partial day */
  seconds = (((tm->hour * 60UL) + tm->minutes) * 60UL) + tm->seconds;

  /* Account for previous complete days */
  {
    /* Start with complete days in current month */
    days = tm->day;

    /* Next, complete months in current year */
    {
      month = tm->month;
      while ( --month >= 0 )
      {
        days += monthLength( IsLeapYear( tm->year ), month );
      }
    }

    /* Next, complete years before current year */
    {
      year = tm->year;
      while ( --year >= BEGYEAR )
      {
        days += YearLength( year );
      }
    }

    /* Add total seconds before partial day */
    seconds += (days * DAY);
  }

  return ( seconds );
}
