OKMCU/wifi-lock/firmware/osal/osal_fifo.c

#include <stdio.h>
#include <string.h>
#include <stdint.h>
#include "osal.h"
#include "osal_config.h"
#include "osal_fifo.h"
#include "hal_assert.h"


typedef struct FIFOPage {
    uint8_t buf[OSAL_FIFO_PAGE_SIZE];
    uint16_t head;
    uint16_t tail;
    struct FIFOPage *nextPage;
} FIFOPage_t;

typedef struct {
    uint32_t datalen;
    FIFOPage_t *headPage;
    FIFOPage_t *tailPage;
} FIFOHandle_t;

extern OSAL_FIFO_t osal_fifo_create(void)
{
    void *handle;
    
    handle = osal_mem_alloc(sizeof(FIFOHandle_t));
    if(handle != NULL)
    {
        osal_memset(handle, 0x00, sizeof(FIFOHandle_t));
    }
    
    return (OSAL_FIFO_t)handle;
}

extern void osal_fifo_delete(OSAL_FIFO_t fifo)
{
    FIFOHandle_t *fifoHandle = NULL;
    FIFOPage_t *fifoPageSav = NULL;
    fifoHandle = (FIFOHandle_t *)fifo;
    
    while(fifoHandle->headPage != NULL)
    {
        fifoPageSav = fifoHandle->headPage->nextPage;
        osal_mem_free(fifoHandle->headPage);
        fifoHandle->headPage = fifoPageSav;
    }
    
    osal_mem_free(fifoHandle);
}

extern uint8_t *osal_fifo_put(OSAL_FIFO_t fifo, uint8_t byte)
{
    uint8_t *pos;
    FIFOHandle_t *fifoHandle = NULL;
    FIFOPage_t *fifoPage = NULL;
    fifoHandle = (FIFOHandle_t *)fifo;

    if(fifoHandle->tailPage == NULL)
    {
        HAL_ASSERT(fifoHandle->headPage == NULL);
        fifoPage = osal_mem_alloc(sizeof(FIFOPage_t));
        if(fifoPage == NULL)
        {
            return NULL;
        }
        fifoPage->head = 0;
        fifoPage->tail = 0;
        fifoPage->nextPage = NULL;
        fifoHandle->headPage = fifoPage;
        fifoHandle->tailPage = fifoPage;
    }

    if(fifoHandle->tailPage->tail >= OSAL_FIFO_PAGE_SIZE)
    {
        HAL_ASSERT(fifoHandle->tailPage->nextPage == NULL);
        fifoPage = osal_mem_alloc(sizeof(FIFOPage_t));
        if(fifoPage == NULL)
        {
            return NULL;
        }
        fifoPage->head = 0;
        fifoPage->tail = 0;
        fifoPage->nextPage = NULL;
        fifoHandle->tailPage->nextPage = fifoPage;
        fifoHandle->tailPage = fifoPage;
        
    }

    pos = fifoHandle->tailPage->buf + fifoHandle->tailPage->tail;
    *pos = byte;
    fifoHandle->tailPage->tail++;
    fifoHandle->datalen++;

    return pos;
    
}

extern uint32_t osal_fifo_len(OSAL_FIFO_t fifo)
{
    return ((FIFOHandle_t *)fifo)->datalen;
}

extern uint8_t osal_fifo_get(OSAL_FIFO_t fifo)
{
    uint8_t u8tmp = 0;
    FIFOHandle_t *fifoHandle = NULL;
    FIFOPage_t *fifoPage = NULL;
    fifoHandle = (FIFOHandle_t *)fifo;

    if(fifoHandle->datalen > 0)
    {
        u8tmp = fifoHandle->headPage->buf[fifoHandle->headPage->head++];
        fifoHandle->datalen--;
        if(fifoHandle->headPage->head == fifoHandle->headPage->tail)
        {
            fifoPage = fifoHandle->headPage->nextPage;
            osal_mem_free(fifoHandle->headPage);
            fifoHandle->headPage = fifoPage;
            if(fifoHandle->headPage == NULL)
            {
                fifoHandle->tailPage = NULL;
            }
        }
    }

    return u8tmp;
    
}
