OKMCU/wifi-lock/firmware/hal/hal_devid.h

#ifndef HAL_DEVID_H
#define HAL_DEVID_H

#ifdef __cplusplus
extern "C"
{
#endif

/*********************************************************************
 * INCLUDES
 */
#include <stdint.h>

/*********************************************************************
 * MACROS
 */
#define HAL_DEVID_SIZE  5
/*********************************************************************
 * CONSTANTS
 */


/*********************************************************************
 * TYPEDEFS
 */


/*********************************************************************
 * GLOBAL VARIABLES
 */
extern void HalDevIdInit (void);
extern uint32_t HalDevIdRead (uint8_t index);
/*********************************************************************
*********************************************************************/

#ifdef __cplusplus
}
#endif

#endif
