OKMCU/wifi-lock/(commit log)

2019-03-19 Code from SVN to Git
    [BOM.xls, CMD.xls, ESP8266_RF_init.xls, MAC_TABLE.CSV, ProductID-ROOM-DEVID-UUID Mapping.xlsx, UI.xls, WiFiFlow.xlsx, WiFi_Lock.PcbDoc]
2019-03-19 Add Quotation Doc
    [密码键盘+磁力锁硬件BOM.xlsx]
2019-03-22 Keil v4 -> Keil V5; Add door unlock but not open timeout alarm; Add door LED indicator.
2019-03-24 Add door open indicator by LED adn timeout alarming by buzzer
    [hal_led.c, main.c]
2019-03-24 Bug-fix: LED not stable; Door Status check wrong.
    [app_lock.c, hal_led.h]
2019-03-25 Bug-fix: Wrong LED number 5, should be 6.
    [hal_led.h]
